vitrum/esp32-fs3000-project/docs/screenshort/IMG_1047.jpg

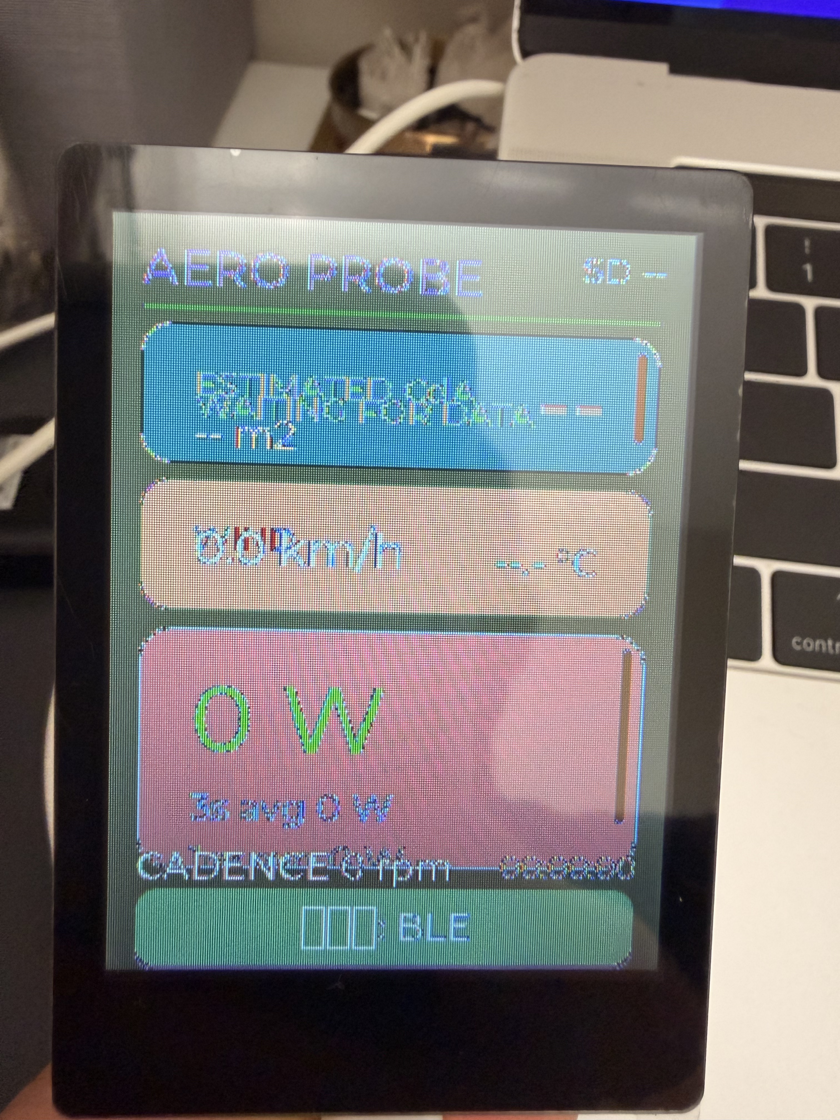
docs/screenshort/IMG_1047.jpg
