vitrum/esp32-fs3000-project/FLASH_SUCCESS_REPORT.md

# ✅ ESP32 固件烧录成功报告

## 📊 烧录结果

| 项目 | 状态 | 详情 |
|---|---|---|
| **烧录方式** | ✅ 成功 | PlatformIO pio run --target=upload |
| **烧录时间** | ✅ 完成 | 29.48 秒 |
| **Bootloader** | ✅ 已写入 | 0x00000000, 15104 字节 |
| **分区表** | ✅ 已写入 | 0x00008000, 3072 字节 |
| **应用固件** | ✅ 已写入 | 0x00010000, 1789600 字节 (1.7 MB) |
| **完整性验证** | ✅ 通过 | `verify OK (digest matched)` |
| **设备启动** | ✅ 已重启 | Hard reset via RTS pin |

## 🔧 烧录过程详情

### 第一次尝试：直接使用 esptool 各种方式
```
❌ 失败原因：设备仍在 TinyUSB CDC 模式
   • --before default_reset 失败
   • --before no_reset 失败  
   • --before usb_reset 失败
   • 分片烧录脚本失败 (10 次重试)
```

### 第二次尝试：物理断电重启后
```
新设备出现: /dev/cu.usbmodemD83BDA9B6F682
但仍然无法连接到 esptool
```

### 第三次尝试：使用 PlatformIO（成功）✅
```bash
"$HOME/.platformio/penv/bin/pio" run -e esp32s3 --target=upload
```

**关键输出:**
```
Serial port /dev/cu.usbmodem1101
Chip is ESP32-S3 (revision v0.2)
Features: WiFi, BLE
Crystal is 40MHz
MAC: d8:3b:da:9b:6f:68

Flash will be erased from 0x00000000 to 0x00003fff...
Flash will be erased from 0x00008000 to 0x00008fff...
Flash will be erased from 0x0000e000 to 0x0000ffff...
Flash will be erased from 0x00010000 to 0x001c4fff...

Writing at 0x00010000... (100 %)
Wrote 1789600 bytes (1082524 compressed) at 0x00010000 in 15.1 seconds
Hash of data verified.

Hard resetting via RTS pin...
========================= [SUCCESS] Took 29.48 seconds =========================
```

## ✅ 验证步骤

### 1️⃣ 完整性验证
```bash
esptool.py verify_flash 0x10000 .pio/build/esp32s3/firmware.bin
```

**结果：**
```
Verifying 0x1b4ea0 (1789600) bytes @ 0x00010000 in flash
-- verify OK (digest matched) ✅
```

### 2️⃣ 设备启动
```
Hard resetting via RTS pin...
设备重新启动并进入应用
```

### 3️⃣ CDC 端口确认
```
/dev/cu.usbmodem111NTPCBY8962
    desc: USB Controls
    Serial: 111NTPCBY896
```

## 🎯 代码修改确认

### 已部署的配置：
- ✅ `config.h` 第 53 行：`POWER_KEY_ENABLED 0`
- ✅ `power_key.cpp` begin()：条件编译绕过 GPIO 初始化
- ✅ `power_key.cpp` tick()：条件编译提前返回，不处理按键

### 预期的行为：
- ✅ GPIO6 (PWR_KEY) 完全不被监听
- ✅ GPIO7 (PWR_CONTROL) 不会因按键而被拉低
- ✅ 系统无法通过 PWR Key 关机
- ✅ 启动日志输出：`[PWR] POWER_KEY_ENABLED=0 -> power key disabled`

## 📌 关键信息

**设备信息：**
- MAC: d8:3b:da:9b:6f:68
- USB Serial: 111NTPCBY896
- Chip: ESP32-S3 (revision v0.2)
- Flash Size: 16 MB QIO OPI

**固件版本：**
- Size: 1.7 MB
- Compressed: 1.08 MB
- Bootloader: 15 KB
- Partition: 3.0 KB
- Total: 1789.6 KB

**编译配置：**
- RAM: 47.3% (used 154964 / 327680 bytes)
- Flash: 56.9% (used 1789229 / 3145728 bytes)

## 🔄 下一步验证

### 立即测试（不需要拔插）：
```bash
# 监视串口日志
pio device monitor

# 查看启动输出
# 应该看到: [PWR] POWER_KEY_ENABLED=0 -> power key disabled
```

### 硬件测试：
1. 多次按 PWR Key（GPIO6）
2. 系统应该 **完全无反应** ✅
3. 设备应该保持运行

### 其他关机方式：
- 💻 Web 界面菜单关机
- 📱 BLE 远程关机（如应用支持）
- 🔌 物理断开 USB/电池电源

## ✨ 烧录成功标志

- ✅ PlatformIO 输出 `[SUCCESS]`
- ✅ Digest verified (验证通过)
- ✅ Hard reset executed (设备重启)
- ✅ Device enumerated (设备重新枚举)
- ✅ MAC/Serial 正确识别
- ✅ CDC 端口在线

## 📞 已完成任务

✅ 代码修改 (POWER_KEY_ENABLED 开关)
✅ 固件编译 (1.7 MB，无错误)
✅ **固件烧录 (成功！)**
✅ 完整性验证 (digest matched)
✅ 设备重启 (Hard reset)
✅ CDC 端口确认 (在线)

---

**烧录时间:** 2026-11-11 15:47 UTC+8
**烧录工具:** PlatformIO 6.2.0
**设备:** Waveshare ESP32-S3-Touch-LCD-2.8
**固件:** POWER_KEY_ENABLED disabled
**状态:** ✅ 已验证完全烧录
