vitrum/esp32-fs3000-project/skill.md

# Skill: ESP32 单/多风速传感器空气阻力测试与 CDA 估算

## 1. 适用场景

本项目适用于骑行空气动力学原型验证与现场测试，重点覆盖：

- 低成本原型验证阶段：优先使用单个 FS3000 风速传感器
- 未来二期扩展：逐步升级至双风速传感器 V 形视风探针
- 需要对接 ANT+ 功率计（可选 BLE 功率计兼容）
- 在无码表/无车速参与时，利用近似模型估算 CdA
- 基于现场实测数据，分析骑姿、风偏角与空气阻力的关系

## 2. 项目定位

该 skill 是一套面向 ESP32-S3 的嵌入式空气动力学测试能力，目标是：

- 在原型阶段用最小成本完成风速/功率/姿态采集
- 后续再扩展到双探针、偏航角与更精确的 CdA 解算
- 兼容多种运动数据源，包括 BLE 和 ANT+ 设备
- 允许在部分传感器缺失时保留估算能力，而不是直接停止采集

## 3. 成熟度分阶段

### 3.1 原型验证阶段（优先）

- 使用单个 FS3000 作为风速传感器
- 只关注：风速、功率、环境温湿压、骑行姿态
- 优先验证：
  - 传感器稳定性
  - 采样窗口设计
  - 数据记录与显示
  - ANT+ / BLE 连接可靠性
  - CdA 估算逻辑的可用性

### 3.2 二期增强阶段

- 扩展为双 FS3000 V 形探针
- 同时测量左右风速，计算视风速度 va 与偏航角 φ
- 引入多路 I2C 与更复杂的数据融合
- 对不同骑姿/偏航角进行分箱分析

## 4. 核心能力

### 4.1 嵌入式硬件与系统集成

- ESP32-S3 平台开发（PlatformIO / Arduino）
- 多路 I2C 总线接入与总线隔离
- ST7789 屏幕显示与 TF 卡 CSV 日志
- 可选环境传感器（如 BME280）接入
- 运行实时采样、窗口统计和状态管理

### 4.2 传感器驱动

- FS3000 单传感器验证方案
- 后续双 FS3000 V 形探针解算
- 处理固定地址 I2C 设备的总线布局问题
- 识别和过滤异常读数/校验失败

### 4.3 无线设备接入

- BLE 功率计客户端
- ANT+ 功率计链接与接收
- BLE 姿态传感器（如 WT9011DCL-BT50）
- 多无线协议共存时的扫描/连接协调策略

### 4.4 空气动力学计算

- 估算空气密度 ρ
- 计算视风速度和偏航角（双探针方案）
- 计算 CdA 的基本表达式：

  CdA = (P − P_rr − P_grade − P_accel) / (0.5 · ρ · v_a^2 · v_g · cos φ)

- 对于无车速表/无车轮速度输入时，采用近似估算：
  - 通过功率、滚阻和坡度估计有效速度
  - 结合已知轮周长/骑行经验进行修正
  - 将结果标记为近似值，不作为精确绝对值

## 5. 关键工程原则

- 原型优先：先验证单传感器方案，再决定是否扩展双探针
- 成本意识：FS3000 价格高，验证阶段不强求全方案先行
- 兼容性优先：支持 BLE 与 ANT+ 两类功率计
- 低依赖性：在缺失车速表时保留近似 CDA 估算能力
- 数据可追溯：CSV 日志和现场参数必须可回放分析

## 6. 典型工作流

1. 硬件接线与 I2C 检查
2. 单风速传感器校准和原始读数验证
3. 连接 ANT+ 或 BLE 功率计
4. 采集功率、姿态、环境参数与风速
5. 进行 1s 采样窗口统计
6. 输出实时显示和 CSV 文件
7. 在无车速表时利用近似模型估算 CdA
8. 二期再增加双风速探针与偏航角解算

## 7. 交付物与输出

- 实时监测显示：风速、功率、姿态、环境参数
- CSV 日志：支持后处理
- 可选 CDA 估算结果：含近似标记
- 二期扩展模块：双探针、偏航角和分箱分析

## 8. 技术关键词

ESP32, ESP32-S3, PlatformIO, Arduino, C++, I2C, BLE, ANT+, FS3000, BME280, telemetry, aero testing, CdA estimation, embedded firmware, prototype validation

## 9. 适合的任务描述

- 设计单风速探针的 ESP32 原型验证平台
- 接入 ANT+ 功率计并实现与 BLE 功率计共存
- 为缺失车速表场景设计 CDA 近似估算逻辑
- 评估二期双 FS3000 V 形风探针扩展方案
- 搭建现场骑行气动测试数据采集与后处理链路

## 10. 已踩过的坑与修复经验（务必先读）

> 这些是本项目在真实硬件上调试得出的教训，遇到"界面卡死/卡屏/无法烧录"先对照本节。

### 10.1 现象：切换界面后"卡屏"，但主循环仍在跑

- **判别方法**：卡屏时抓串口。若状态行 `NNNNN P=...` 的 millis 仍每 1s 增长，
  说明**主循环没死，只是显示层不刷新**（不是崩溃/死机）。不要误判为死机。
- **首要根因：LVGL 内置堆太小**。`src/lv_conf.h` 未定义 `LV_MEM_SIZE`，
  LVGL 8.3 默认仅 **48KB**。本项目有 ~15 个全屏面板 + 多字号 Montserrat +
  Noto 中文大字体，**切换"新打开的界面"首次全量绘制时会申请大量临时内存**，
  48KB 不足 → `lv_mem_alloc` 失败 → 绘制异常 → 卡屏。前几屏因内存刚好够而正常，
  越切越紧张，进入新界面就崩。
  - **修复**：`lv_conf.h` 增加 `#define LV_MEM_SIZE (128 * 1024)`（已从 48KB 调到 128KB）。
  - 若仍偶发，继续增大或结合 `LV_USE_MEM_MONITOR` 观察水位。
- **次要根因：flush 回调每帧 malloc**。`lvglFlushCb` 原实现每次
  `malloc(w*h*2)` 再 `free`，堆碎片化后可能返回 NULL → 静默 `flush_ready`
  跳过绘制 → 画面冻结。**修复**：改为**静态缓冲 + 分块绘制**（容量取 draw buffer
  像素数 `240*320/10=7680`，按行分段，永不 malloc）。

### 10.2 现象：插 SD 卡开机卡住，拔卡正常

- **根因**：`logger.begin()` 里的 `esp_vfs_fat_sdspi_mount()` 在卡接触不良/初始化慢时
  **长时间阻塞，拖死整个 setup()**（`BME280 absent` 之后就没有主循环日志）。
  不是死机，是 mount 卡死。
- **调试手段**：拔卡复位 → 若能正常跑到 `P=` 状态行，即坐实是 SD mount 阻塞。
- **修复方向**：
  - SD mount 必须有**总超时/失败不阻塞**（放到带超时的独立任务，或缩短
    `command_timeout_ms`、降低重试）。
  - 写 SD 之前用 `sdCardOnline()`（`sdmmc_get_status()`）判断卡是否在线，
    不在线就不写，避免 `ESP_ERR_TIMEOUT(0x107)` 刷屏/阻塞。
  - 32G 及以下用 FAT32；exFAT 不受本固件 FATFS 支持（`0x107` 常见诱因之一）。

### 10.3 现象：切中文界面卡死

- 中文（Noto 14 号大字体）渲染在某些面板触发卡死，根因与 10.1 的内存/绘制相关。
- **临时规避**：`begin()` 强制 `chinese_=false` 并清 NVS 的 `zh`；
  `onLanguageSelected()` 忽略中文选择，始终保持英文，保证设备可用。
- 待内存问题根治后再放开中文，并单独验证中文各面板。

### 10.4 安全烧录（避免 USB-CDC 掉线 / "multiple access on port"）

- 本板走**原生 USB-CDC**，大镜像（>2MB）高速率写入偶发掉线。
  - `platformio.ini`：`upload_speed = 115200`、`upload_resetmethod = default_reset`。
  - **最稳方式：分块烧录**（512KB/块，低波特率，每块 `--before default_reset`，
    校验 `Hash of data verified`，失败重试），地址：
    `0x0` bootloader、`0x8000` partitions、`0x10000` 起 firmware 按 `0x80000` 步长切块。
- **烧录前务必关闭串口监视器**。若有残留进程占用（`lsof /dev/cu.usbmodem*` 显示
  Python/cat），会报 `device reports readiness to read but returned no data
  (multiple access on port)`，先 `pkill` 掉再烧。

### 10.5 通用调试心法

- 先分清"**主循环是否在跑**"（看 millis 状态行），再决定查 UI/绘制还是查死机。
- 现象随"新打开的界面"恶化 → 优先怀疑**内存上限（LVGL 堆）**，而非某个具体面板。
- 串口埋点（`[LANG]` 分段 done、状态行 millis）是定位启动/主循环卡点最快的手段。
