vitrum/esp32-fs3000-project/code/docs/数据传输技术方案分析.md

# ESP32-S3 移动传感器数据传输技术方案分析报告（更新版）

> 版本：v2.0　|　适用平台：Waveshare ESP32-S3-Touch-LCD-2.8
> 本文所有关键技术参数均来自 Espressif 官方文档（ESP-IDF Programming Guide）与产品规格，文末附来源。
> 标注「实测参考」的数据为社区普遍反馈的经验值，标注「官方」的为核心技术约束，请区别对待。

---

## 一、核心需求场景

| 项 | 描述 |
|---|---|
| 移动端 | 微雪 ESP32-S3-Touch-LCD-2.8（2.8 寸 240×320 电容触摸屏），持续移动中采集传感器数据 |
| 接收端 | 电脑或手机，位于 **100 米视线距离**（空旷无障碍）的固定位置 |
| 数据特征 | 小型、高频、实时的传感器数据流（本项目为功率/踏频/风速/姿态等遥测帧） |
| 核心目标 | 解决移动状态下 100 米远距离传输的信号衰减问题，实现高可靠、低延迟的数据交互 |

**本项目的实际数据流参考**（来自现有实现 `wifi_web.h`）：
传感器以 8Hz 采样，聚合成 1Hz 遥测帧，经 WebSocket 推送，单帧约 200~400 字节。
即**有效带宽需求 < 1 kbps**，这对任何无线方案都是极低的负载——因此本场景的真正瓶颈
**不是带宽，而是链路可靠性、覆盖距离与部署复杂度**。这一判断贯穿全文。

---

## 二、交互分析与技术瓶颈演进

### 2.1 随身 WiFi 的局域网组网可行性

**结论：理论可行，但有严重的前置条件限制。**

**瓶颈原因：**

1. **AP 隔离（AP Isolation / Client Isolation）**
   多数随身 WiFi / 手机热点的默认策略是隔离同一 AP 下的客户端互访，
   这是运营商的**安全默认值**，会直接拦截「ESP32 → 电脑」的局域网直连。

2. **系统防火墙**
   即使关闭 AP 隔离，Windows 首次遇到未知入站连接会默认拦截，
   macOS 也会弹出「是否允许接受传入连接」。用户侧极易配置失败。

3. **DHCP 地址漂移**
   热点重启后接收端 IP 常变化（如 `192.168.43.100` → `192.168.43.101`），
   硬编码目标 IP 的推送代码会直接失效，需要额外的设备发现机制（mDNS / UDP 广播）。

4. **⚠️ 与项目现有架构的冲突（重要）**
   本项目 `WifiWeb` 的定位是 **STA 客户端 + WebSocket 服务端**，
   数据由**浏览器/客户端主动订阅**。而方案二要求 ESP32 作为**主动推送方**（UDP/TCP Client）。
   这一改动不是「加几行代码」，而是需要新增独立的发送通道，
   并处理与 LVGL 主循环的线程安全（WebSocket 回调运行在 AsyncTCP 任务中，
   直接操作 LVGL 会崩溃——本项目已有 `ui_navigation_guard.h` 专门处理此类问题）。

**评价**：可行但脆弱，属于「能跑通，但现场部署成功率低」的方案。

---

### 2.2 100 米无线视线传输瓶颈

**结论：普通便携随身 WiFi 或 ESP32 板载天线的默认 802.11b/g/n 模式，确实无法稳定支撑 100 米移动传输。**

**瓶颈原因（含官方数据）：**

1. **板载天线的物理限制**
   便携随身 WiFi 与微雪开发板均为板载 PCB 天线，增益通常仅 2~3 dBi，
   且辐射方向图在设备旋转时存在明显零点（null）。
   > 实测参考：开阔环境下稳定距离通常 30~50 米，与文档原始结论一致。

2. **自由空间路径损耗（FSPL）**
   2.4 GHz 下，距离每翻倍损耗增加约 6 dB：

   ```
   FSPL(dB) = 20·log10(d) + 20·log10(f) − 147.55     (d 单位 m, f 单位 Hz)
   ```

   2.4 GHz 在 1 m 处约 40.0 dB，100 m 处约 **80.0 dB**。
   若发射功率 20 dBm、接收灵敏度 −90 dBm，链路预算约 110 dB，
   扣除 80 dB 路径损耗后仅剩 **30 dB 余量**——听起来够用，
   但人体遮挡可再衰减 **10~20 dB**，设备旋转再损失 5~10 dB，
   余量迅速归零。这正是「静止能通、一动就断」的物理原因。

3. **多径效应与阴影效应**
   持续移动中，人体遮挡、设备角度旋转导致 2.4 GHz 信号快速衰落；
   OFDM 在低 SNR 下会主动降速率，重传率飙升，表现为「延迟抖动极大」。

4. **漫游/重连开销**
   STA 模式一旦断开，重连需重新扫描 + 认证 + DHCP，
   典型耗时 **1~5 秒**，期间数据完全丢失。移动场景下这会发生得非常频繁。

**✅ 关键补充：ESP32 原生支持 Long Range 模式**

这是原始文档遗漏的重要能力。ESP-IDF 官方文档明确说明：

> 「The Espressif-specific ESP-NOW protocol and **Long Range mode, which supports up to 1 km of data traffic**」
> —— ESP32 Wi-Fi Feature List（ESP-IDF v6.1）

Long Range 模式即 **802.11 LR**（Espressif 私有扩展，基于 802.11b 的 DSSS 扩频调制），
官方定义的速率档位只有两档：

```c
WIFI_PHY_RATE_LORA_250K = 0x29,  /**< Espressif-specific Long Range mode rate, 250 Kbps */
WIFI_PHY_RATE_LORA_500K = 0x2A,  /**< Espressif-specific Long Range mode rate, 500 Kbps */
```

速率降低换来的正是**接收灵敏度提升**，链路预算显著优于标准 11b/g/n。
对本项目而言，1Hz × 300 字节 ≈ **2.4 kbps** 的需求，
**250 kbps 的 LR 速率仍有 100 倍余量**，完全不必担心降速影响。

启用方式（`esp_wifi_set_protocol`，官方 API）：

```c
// 官方文档：When WiFi band mode is 2.4G only, support 802.11b or 802.11bg
// or 802.11bgn or 802.11bgnax or LR mode
esp_wifi_set_protocol(WIFI_IF_STA, WIFI_PROTOCOL_LR);
```

> ⚠️ **重要约束**：LR 模式**必须双方都支持**。
> 普通路由器、手机热点**不支持** LR，因此 LR 只能用于 **ESP ↔ ESP** 的点对点场景。
> 这直接决定了：**LR 是方案三（ESP-NOW）的专属优势，无法用于方案一/二的 WiFi 组网。**

---

### 2.3 外接 5G 模块改造的可行性

**结论：理论可行，但属于高难度、高风险的非最优解。**

**瓶颈原因：**

1. **引脚冲突（本项目实测确认）**
   微雪该板高度集成屏幕（SPI）、触摸（I2C）、SD 卡（SPI）、音频（I2S）、GPS（UART）。
   查看本项目 `config.h` 可知已占用引脚：

   | 功能 | 引脚 |
   |---|---|
   | LCD SPI | 45/40/42/41/39/5 |
   | 触摸 I2C | 1/3/4/2 |
   | I2C1（传感器） | 11/10 |
   | I2C2 | 15/18（15 与 GPS_PPS 复用） |
   | SD 卡 SPI | 14/16/17/21 |
   | 电源按键 | 6/7 |
   | I2S 音频 | 48/38/47 |
   | GPS UART | 43/44 |
   | BOOT | 0 |

   实测汇总（`grep PIN_ src/config.h`）后，
   **真正空闲可用的仅 GPIO 8/9/12/13/19/20/46**（22~25 不存在，26~37 被 Flash/PSRAM 占用）。
   5G 模组需要 USB 2.0 高速接口（或至少多路 UART + 电源控制），
   **被迫只能走单路 UART AT 指令**，带宽受限、扩展性被破坏。

2. **供电灾难（物理硬约束）**
   5G 模组搜网/发射瞬间电流峰值达 **2~3 A**，
   而微雪板载 LDO（ME6217C33M5G，800 mA 输出）**远不足以支撑**，
   会导致电压跌落 → ESP32 欠压复位 → 反复重启，甚至损坏 LDO。
   若一定要做，必须**独立供电 + 大电容缓冲**，已超出「开发板改造」的范畴。

3. **成本与体积**
   5G 模组 + SIM + 独立电源管理，成本可能超过开发板本身，且体积臃肿。

**评价**：不推荐。若确实需要广域联网，**方案一（口袋 WiFi）** 是同等效果、零风险的替代。

---

## 三、最终优选解决方案评级

### 🥇 方案一：口袋 WiFi + 云端物联网平台（MQTT）中转

**架构设计：**

```
[ESP32-S3] ──WiFi(厘米级)── [口袋 WiFi/4G 路由器] ──运营商基站── [互联网]
                                                                    │
                                                          [MQTT Broker]
                                                                    │
[固定端 电脑/手机] ──────────── 任意网络（WiFi/4G/有线）────────────┘
```

将微雪板与口袋 WiFi **捆绑在一起移动**，两者距离仅厘米级，
WiFi 信号处于绝对完美的顶格状态（RSSI 通常 −30 ~ −40 dBm）。

**通信机制：**

- 口袋 WiFi 连接运营商基站接入互联网。
- ESP32-S3 作为 **MQTT Client**，将传感器数据 **Publish** 到云端 Broker。
- 固定端连接任意网络，**Subscribe** 相同 Topic 实时接收。

**为什么这是最优解：**

| 优势 | 说明 |
|---|---|
| **彻底消灭距离限制** | 传输距离从「100 米」变成「全球可达」 |
| **完美绕过 AP 隔离/防火墙** | 通信由 ESP32 主动发起走向公网，不涉及局域网互访 |
| **工业级标准** | MQTT 轻量、发布/订阅、支持 QoS 1/2 保证送达 |

**✅ 技术可行性（本项目实测依据）：**
本项目已基于 ESP-IDF 实现完整的 `WifiWeb` 模块（`src/wifi_web.h`），
包含 SmartConfig 配网、STA 连接、断线重连、WebSocket 推送，
**证明该平台跑通「WiFi + 长连接 + 实时推送」链路完全可行**。
迁移到 MQTT 只需替换传输层：
- ESP-IDF 官方组件：`espressif/mqtt`（ESP-MQTT，支持 MQTT v5.0）
- 示例：`protocols/mqtt`（TLS + 证书验证）

> ⚠️ **必须正视的代价（原始文档未提及）：**
>
> 1. **延迟增加**：数据需经「ESP32 → 口袋 WiFi → 基站 → 公网 → Broker → 固定端」，
>    典型端到端延迟 **100~500 ms**（公网 + 运营商 NAT）。
>    对「1Hz 遥测」完全可接受，但**不适用于需要 <10ms 的实时控制**。
> 2. **依赖移动网络覆盖**：山区、地下室、隧道内会失联。
>    **建议保留 SD 卡本地记录作为兜底**——本项目已实现完整 FIT/CSV 记录，正好互补。
> 3. **流量成本**：1Hz × 300 字节 ≈ **2.6 MB/小时**，按 4G 资费需评估。
>    可通过降低频率或改用二进制载荷（如 CBOR）压缩 60%+。
> 4. **TLS 内存开销**：MQTT over TLS 握手需约 **40~50 KB** 堆内存。
>    本项目当前 RAM 已用 45.4%（约 148 KB / 320 KB），
>    **开启 TLS 前需评估剩余堆空间**，必要时改用非加密端口或 PSK。

**公共测试 Broker（免注册，快速验证）：**
`broker.emqx.io:1883`（TCP）/ `:8883`（TLS）——适合原型验证，**生产环境禁止使用**。

---

### 🥈 方案二：口袋 WiFi + 本地局域网主动推送

**架构设计：**
同样将板子与口袋 WiFi 捆绑，但**必须关闭 AP 隔离**。
ESP32 作为 Client，用 UDP 或 TCP Socket **主动推送到固定端 IP:Port**。

**优缺点：**

| 优点 | 缺点 |
|---|---|
| 延迟极低（同局域网通常 <5 ms） | AP 隔离需手动关闭，现场易失败 |
| 不经云端，无需公网/流量费 | 目标 IP 常变（DHCP），需设备发现机制 |
| 单片机开销小 | 无 QoS 保证，UDP 丢包无感知 |
| 数据不出内网（隐私性好） | **禁止 ESP32 做 HTTP 服务端**（见下） |

> **⚠️ 关于「禁止 ESP32 充当 HTTP 服务器」的澄清：**
> 原始结论方向正确，但表述需要修正。
> 本项目**已经**在 ESP32 上运行 `AsyncWebServer`（异步非阻塞），
> 并未导致 LVGL 卡顿——关键在于 **异步架构** 与 **回调中不触碰 LVGL**。
> 真正会导致卡死的是：
> ① 在 HTTP 回调中直接操作 LVGL 对象；② 在主循环中同步阻塞等待网络。
> 本项目通过 `ui_navigation_guard.h` 与「只置标志位、主循环消费」的模式规避了此问题。
> **因此：「ESP32 可以安全地做 HTTP 服务端，前提是严格异步 + 线程安全」。**

**技术方案对比（UDP vs TCP）：**

| 维度 | UDP 单播 | TCP Socket | ESP-NOW（见方案三） |
|---|---|---|---|
| 延迟 | 最低 | 低 | 最低（免握手） |
| 丢包处理 | 需应用层序号 | 自动重传 | 需应用层序号 |
| 连接开销 | 无 | 三次握手 | 无连接 |
| 适用 | 高频遥测（丢帧可容忍） | 需可靠传输 | 中短距点对点 |

**评价**：适合**纯内网、可控环境**（如实验室、固定场地测试）。
现场部署可靠性低于方案一。

---

### 🥉 方案三：纯硬件不对称升级（ESP-NOW 专网 + 高增益基站）

**架构设计：**

```
[微雪板 + 板载天线]  ──ESP-NOW / 802.11 LR──  [ESP32 基站 + IPEX 高增益天线]
     (移动端)                                           │ USB 串口
                                                  [电脑 上位机]
```

抛弃随身 WiFi，利用 Espressif 私有协议 ESP-NOW（**无连接、2.4 GHz**）。

**ESP-NOW 官方技术规格（ESP-IDF v6.1 文档）：**

| 项目 | 参数 |
|---|---|
| 默认速率 | **1 Mbps**（可通过 `esp_now_set_peer_rate_config` 调整） |
| 最大载荷 | v1.0 **250 字节** / v2.0 **1470 字节** |
| 加密 | CCMP（AES-128），PMK + 每设备 LMK |
| 配对设备数 | 总数最多 **20**（`ESP_NOW_MAX_TOTAL_PEER_NUM`），加密最多 **6**（`ESP_NOW_MAX_ENCRYPT_PEER_NUM`，可 Kconfig 调整） |
| 信道 | 0~14（双方必须**同信道**） |
| 连接 | **无连接**，收到即回调 |

**✅ 与 Long Range 模式叠加（关键增益）：**
ESP-NOW 可配合 `WIFI_PROTOCOL_LR` 使用，
官方标称 LR 模式可支撑 **1 km** 链路——**远超 100 米需求，余量充足**。

```c
// 发送端与接收端都必须设置（注意：ESP-NOW 默认 1 Mbps，LR 才会降低速率提升灵敏度）
esp_wifi_set_protocol(WIFI_IF_STA, WIFI_PROTOCOL_LR);

// esp_now_rate_config_t 是 wifi_tx_rate_config_t 的 typedef，字段以 esp_wifi_types.h 为准。
// 必须先在 esp_wifi_start() + esp_now_add_peer() 之后调用。
// ⚠️ LR 模式下 rate 应使用 WIFI_PHY_RATE_LORA_250K（本项目使用的 ESP32-S3 特有速率），
//    具体枚举名随 IDF 版本不同，请以所用版本的 esp_wifi_types_generic.h 为准。
esp_now_rate_config_t cfg = {};
cfg.phymode = WIFI_PHY_MODE_LR;   // 关键：LR PHY（扩频，灵敏度提升）
cfg.rate    = WIFI_PHY_RATE_LORA_250K;
cfg.ersu    = false;
cfg.dcm     = false;
esp_now_set_peer_rate_config(peer_mac, &cfg);
```

**优缺点：**

| 优点 | 缺点 |
|---|---|
| **无需网络/流量/云端，零月费** | **需要写两端代码**（发送端 + 接收端） |
| **延迟极低**（官方：无连接，收即回调） | 基站需额外一块 ESP32 硬件 |
| LR 模式理论覆盖 1 km | **双方必须同信道**，信道受干扰时需手动切换 |
| 800 米内大概率稳定 | 无内置重传，**需应用层加序号 + ACK** |
| 完全离线，隐私性最佳 | 电脑侧需串口/驱动，体验不如网页 |

> ⚠️ **ESP-NOW 可靠性设计要点（必须自行实现）：**
> 官方文档明确指出：
> 「It is **not guaranteed** that application layer can receive the data.
> If necessary, send back ack data when receiving ESP-NOW data.
> If receiving ack data timeouts, **retransmit** the ESP-NOW data.
> A sequence number can also be assigned to ESP-NOW data to **drop the duplicate data**.」
>
> 即：ESP-NOW 的 `SEND_SUCCESS` **仅代表 MAC 层发出**，
> **不代表应用层收到**。生产环境必须实现：① 应用层 ACK；② 超时重传；③ 序列号去重。

**评价**：技术上最优（延迟最低、无月费、覆盖充足），
但**开发工作量最大**（两端固件 + 上位机），适合长期固定部署。

---

## 四、三方案横向对比与选型建议

| 维度 | 🥇 MQTT 云端 | 🥈 局域网推送 | 🥉 ESP-NOW + LR |
|---|---|---|---|
| **有效距离** | 全球（依赖 4G 覆盖） | ~30~50 m（WiFi 极限） | **100 m 轻松，理论 1 km** |
| **端到端延迟** | 100~500 ms | < 5 ms | **< 5 ms** |
| **可靠性** | 高（QoS 1/2 + 重连） | 中（UDP 丢包） | 中（需自建 ACK/重传） |
| **部署难度** | 低（需配网 + Broker） | 高（关隔离 + 防火墙 + IP） | 中（需第二块板） |
| **持续成本** | 流量费 + Broker 费 | 无 | **无** |
| **离线可用** | ❌ 依赖公网 | ⚠️ 依赖局域网 | ✅ **完全离线** |
| **隐私性** | 数据经公网 | 内网 | **最佳** |
| **开发工作量** | 中 | 中 | **高（两端 + 上位机）** |
| **与现有代码契合** | **高**（已有 WiFi/WebSocket 栈） | 中 | 低（需全新实现） |

### 选型决策树

```
是否需要「任意地点、任意距离」接收？
├─ 是 ──→ 🥇 MQTT 云端（配合 SD 卡兜底）
└─ 否（固定场地，如实验室/赛场）
    ├─ 能否接受额外一块 ESP32 + 写两端代码？
    │   ├─ 能 ──→ 🥉 ESP-NOW + LR（最优延迟、零月费、室内 100m 富余）
    │   └─ 不能 ──→ 🥈 局域网推送（需可控网络环境）
```

### 推荐组合（工程实践）

> **🥇 MQTT 云端 + SD 卡本地记录（双通道）**
>
> 这是最稳妥的工业级组合，理由：
> 1. 实时性：MQTT 满足 1Hz 遥测；
> 2. 完整性：网络中断时 SD 卡完整记录，事后补传；
> 3. 本项目**两者均已具备**（`wifi_web` + `csv_logger`/`fit_export`），
>    只需增加 MQTT 发布层，**改动最小、风险最低**。

---

## 五、针对本项目的落地建议

### 5.1 若采用方案一（推荐）

1. **保留 SD 卡记录**作为离线兜底，不做「只传不存」的设计。
2. **MQTT 载荷用二进制**（struct 直发），而非 JSON 字符串，
   可将 300 字节压到 ~80 字节，流量降 70%。
3. **QoS 选择**：遥测用 **QoS 0**（最省流量，丢帧可容忍）；
   关键事件（开始/停止记录）用 **QoS 1**。
4. **TLS 内存评估**：当前 RAM 45.4%，TLS 需 +40~50 KB，
   **建议先做非加密原型验证，再评估是否启用 TLS**。
5. **保留现有 WebSocket** 作为「同一 WiFi 下的低延迟调试通道」。

### 5.2 若采用方案三（离线优先）

1. **基站端**建议用 ESP32-S3 + IPEX 外置天线，
   **务必两端都设 `WIFI_PROTOCOL_LR`**，否则 LR 优势失效。
2. **信道固定**（如 Channel 1），避免自动信道导致失联。
3. 必须实现 **ACK + 重传 + 序列号去重**（官方明确不保证送达）。
4. 上位机可用 **pyserial + 简单二进制协议**，无需额外驱动。

### 5.3 关键风险提示（本项目特有）

| 风险 | 说明 | 缓解 |
|---|---|---|
| **RAM 吃紧** | 45.4% 已用，TLS/MQTT 会再增 | 先测堆余量，必要时降 TLS |
| **LVGL 线程安全** | 网络回调中碰 LVGL 必崩 | 沿用 `ui_navigation_guard.h` 模式 |
| **供电峰值** | 5G/WiFi 发射瞬间电流大 | 板载 LDO 仅 800 mA，**禁止外接 5G** |
| **GPS 与 WiFi 共存** | 两者任务抢占 CPU | 本项目已有 `system_coexistence` 测试覆盖 |

---

## 六、结论

1. **原始文档的两个核心判断正确**：
   ① 板载天线的默认 WiFi 无法稳定支撑 100 米移动传输；
   ② 外接 5G 模组在供电和引脚上均不可行。

2. **需要补充的重要结论**：
   - ESP32 的 **Long Range 模式官方标称 1 km**，这是方案三的核心技术支撑，
     也是「100 米」需求最经济的解法（**无需任何云端/流量**）。
   - 方案一的真实代价是 **100~500ms 延迟 + 依赖公网 + 流量费**，
     应配合 SD 卡兜底，而非替代本地记录。

3. **最终推荐**：
   - **需要远程/任意地点接收** → 🥇 **MQTT 云端 + SD 卡双通道**（本项目改动最小）。
   - **固定场地、追求低延迟零月费** → 🥉 **ESP-NOW + Long Range**（100 米余量充足）。

---

## 附录 A：关键公式与参数速查

**自由空间路径损耗**
```
FSPL(dB) = 32.44 + 20·log10(d_km) + 20·log10(f_MHz)
2.4 GHz @ 100 m  ≈ 80.0 dB
2.4 GHz @ 1 km   ≈ 100.0 dB
```

**链路预算（接收端功率）**
```
P_rx = P_tx + G_tx + G_rx − FSPL − L_margin
典型：20 dBm + 2 dBi + 2 dBi − 80 dB = −56 dBm   （100 m，完全无遮挡）
人体遮挡 −15 dB                      → −71 dBm  （仍可通，11b 灵敏度约 −90 dBm）
强遮挡 + 设备旋转 −30 dB             → −86 dBm  （临界，需 LR / 高增益天线）
```
> 11b 灵敏度约 −90 dBm，11n 约 −70 dBm。这也是**移动场景脆弱的根因**：
> 一旦降到 11n 速率档，−71 dBm 已接近极限；而 LR 模式灵敏度更低，余量充足。

**Long Range（LR）速查（官方枚举值）**
```
WIFI_PHY_MODE_LR           = 低速率 PHY 模式
WIFI_PHY_RATE_LORA_250K    = 0x29, 250 Kbps
WIFI_PHY_RATE_LORA_500K    = 0x2A, 500 Kbps
```

**本项目带宽估算**
```
1 Hz × 300 字节 = 300 B/s ≈ 2.4 kbps ≈ 1.05 MB/小时
二进制压缩后 ≈ 80 字节/帧 ≈ 0.64 kbps ≈ 0.28 MB/小时
```

## 附录 B：参考资料（Espressif 官方）

| 内容 | 来源 |
|---|---|
| Long Range 支持 1 km | ESP-IDF Wi-Fi Feature List，`api-guides/wifi-driver/overview.html` |
| `WIFI_PROTOCOL_LR` 属 2.4G 可选协议 | ESP-IDF `api-reference/network/esp_wifi.html` |
| ESP-NOW 帧格式/速率/载荷/ACK 语义 | ESP-IDF `api-reference/network/esp_now.html` |
| ESP-NOW Rate Config / LR PHY | `esp_now_set_peer_rate_config` API |
| Wi-Fi 吞吐 / 省电 / 缓冲区 | `api-guides/wifi-driver/wifi-performance-and-power-save.html` |
| ESP-MQTT（v5.0，TLS 示例） | ESP-IDF `api-reference/protocols/mqtt.html` |
| 板载资源与引脚 | Waveshare ESP32-S3-Touch-LCD-2.8 官方 Wiki |
| 本项目引脚占用 | `code/src/config.h` |
| 本项目 WiFi 架构 | `code/src/wifi_web.h` |
