vitrum/esp32-fs3000-project/code/output/imu_position_visualization.png

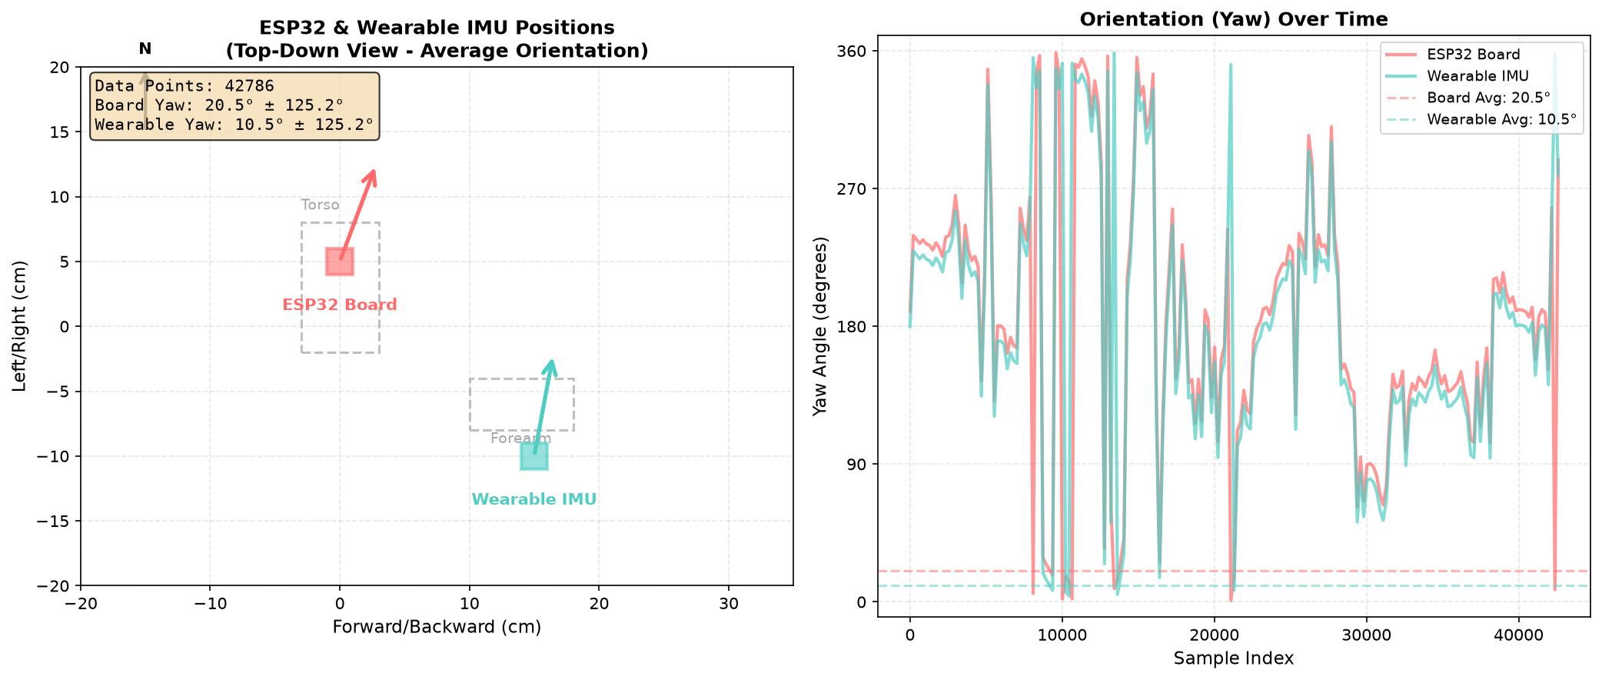
code/output/imu_position_visualization.png
