vitrum/esp32-fs3000-project/docs/ESP32-S3-Touch-LCD-2.8-introduction-03-d0ba2f9f1b4e9e7c740633f970b7858b.webp

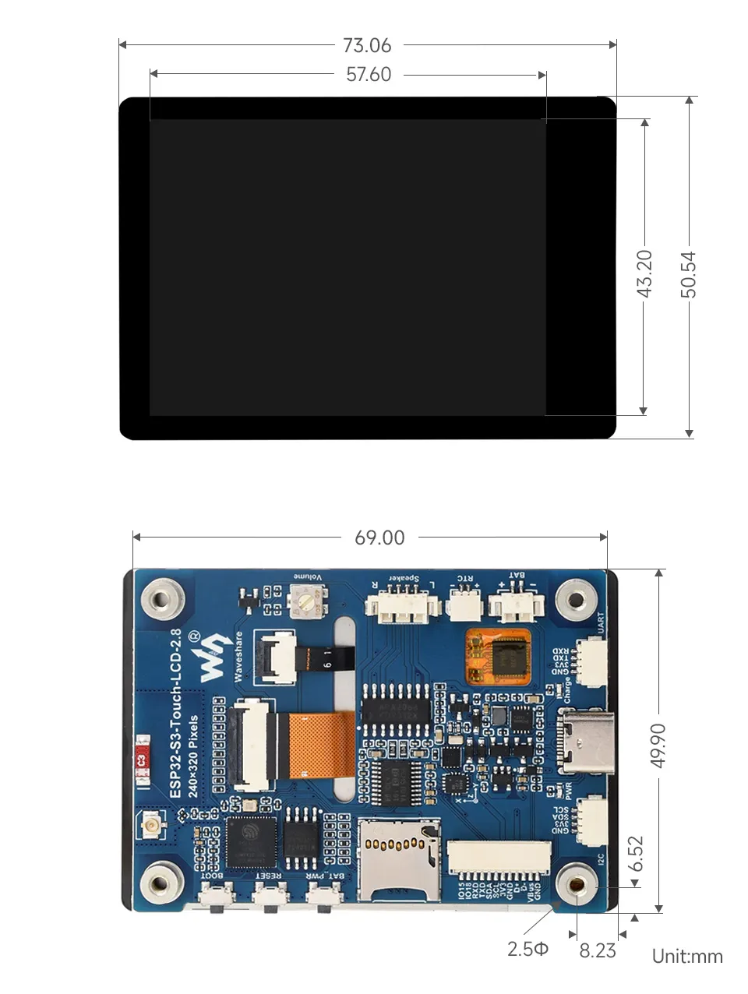
docs/ESP32-S3-Touch-LCD-2.8-introduction-03-d0ba2f9f1b4e9e7c740633f970b7858b.webp
