vitrum/esp32-fs3000-project/cad/aerodynamic_V15.stl

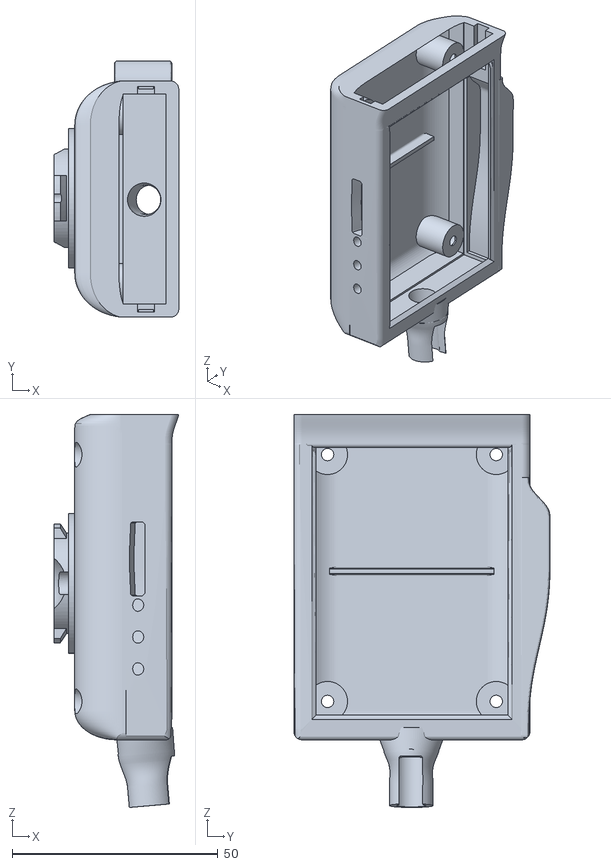
[picture p5: CAD file, 2026-11-05]
cad/aerodynamic_V15.stl
30.3 x 62.3 x 95.5
