vitrum/esp32-fs3000-project/cad/esp32-s3-touch-lcd-2_8_revised_stls/obj_5_esp32-s3-touch-lcd-2_8_5.stl

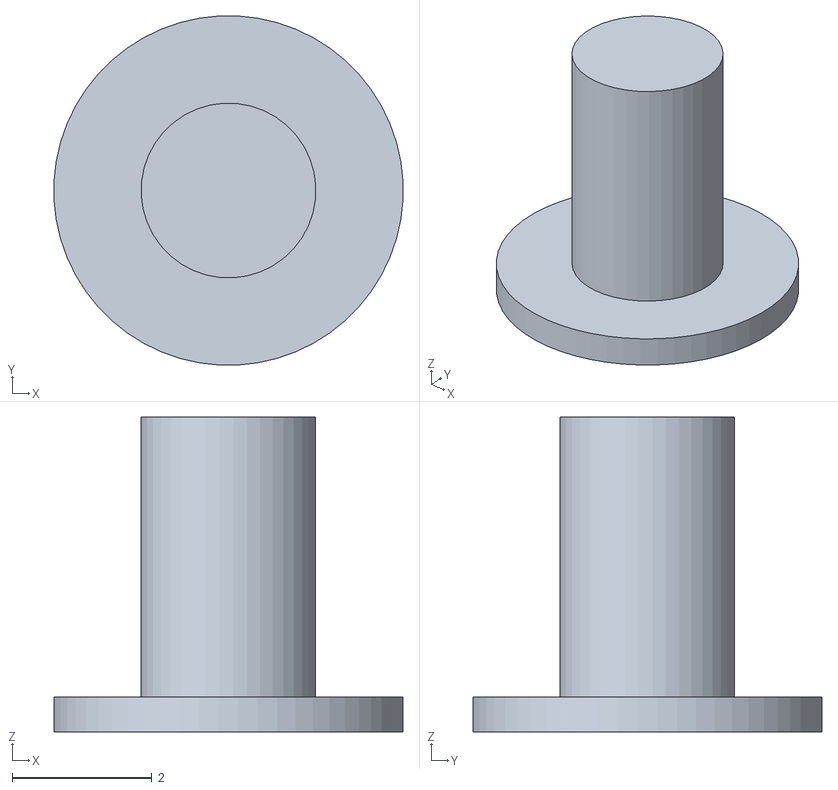
[picture p6: CAD file, 2026-10-12]
cad/esp32-s3-touch-lcd-2_8_revised_stls/obj_5_esp32-s3-touch-lcd-2_8_5.stl
4.99 x 4.99 x 4.50
