vitrum/esp32-fs3000-project/cad/aerodynamic_cycling_computer_V5_rounded_edges_f6.stl

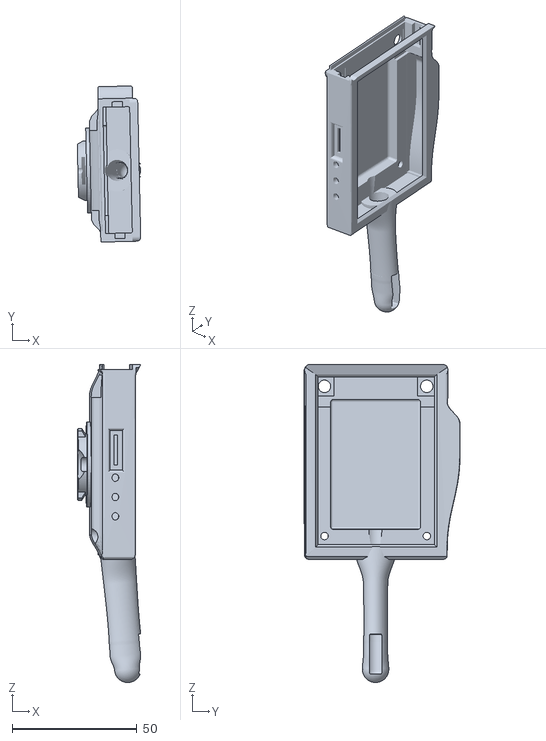
[picture p7: CAD file, 2026-10-16]
cad/aerodynamic_cycling_computer_V5_rounded_edges_f6.stl
25.4 x 62.5 x 127.4
