vitrum/esp32-fs3000-project/cad/esp32-s3-touch-lcd-2_8_revised_stls/obj_2_esp32-s3-touch-lcd-2_8_4.stl

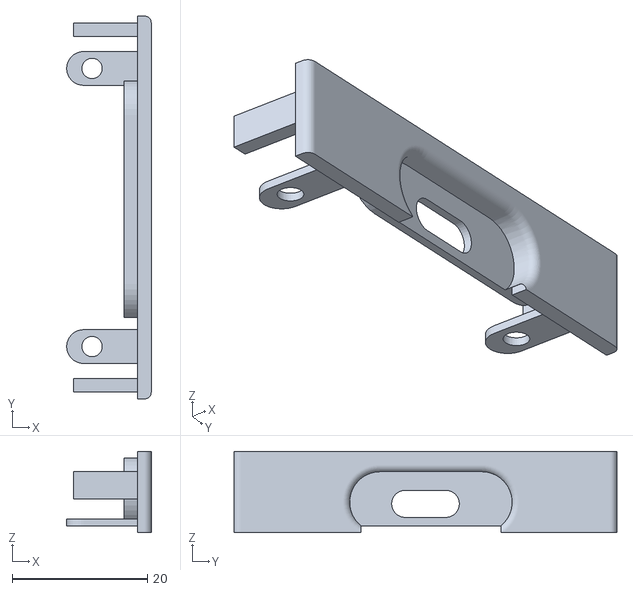
[picture p8: CAD file, 2026-10-12]
cad/esp32-s3-touch-lcd-2_8_revised_stls/obj_2_esp32-s3-touch-lcd-2_8_4.stl
12.5 x 56.6 x 12.0
