vitrum/esp32-fs3000-project/cad/aerodynamic_cycling_computer_V3_spherical_probe.stl

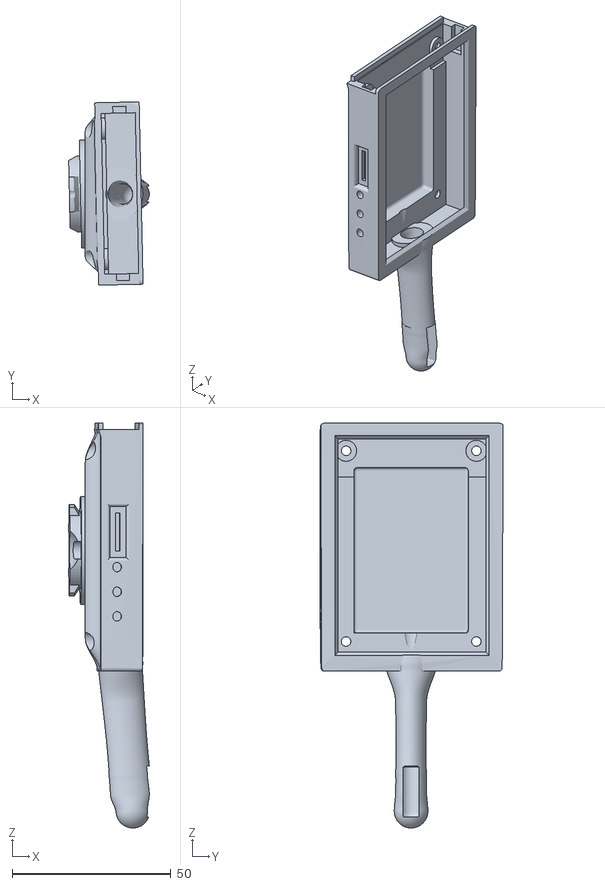
[picture p9: CAD file, 2026-10-15]
cad/aerodynamic_cycling_computer_V3_spherical_probe.stl
25.4 x 57.7 x 127.4
