vitrum/esp32-fs3000-project/cad/esp32-s3-touch-lcd-2_8_revised_stls/obj_1_esp32-s3-touch-lcd-2_8_3.stl

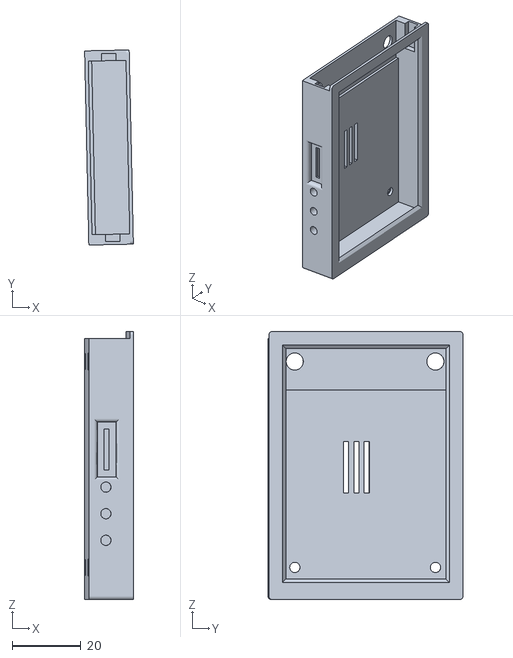
[picture p10: CAD file, 2026-10-12]
cad/esp32-s3-touch-lcd-2_8_revised_stls/obj_1_esp32-s3-touch-lcd-2_8_3.stl
14.2 x 56.9 x 78.1
