vitrum/esp32-fs3000-project/cad/aerodynamic_cycling_computer_print_reinforced.stl

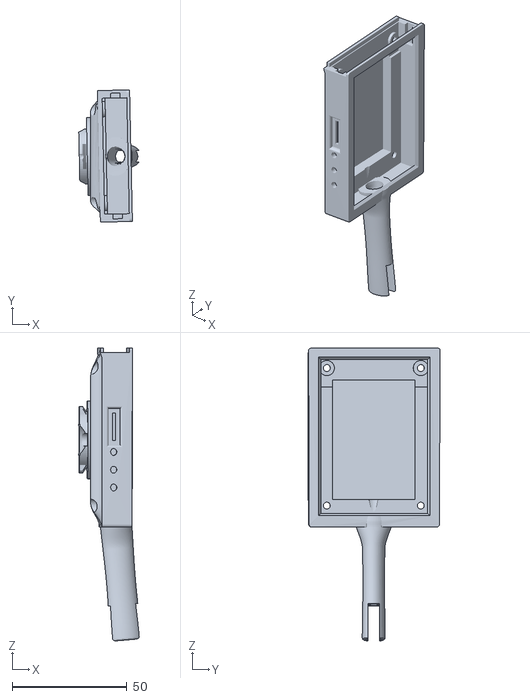
[picture p11: CAD file, 2026-10-15]
cad/aerodynamic_cycling_computer_print_reinforced.stl
26.4 x 57.7 x 127.8
