vitrum/esp32-fs3000-project/cad/aerodynamic_cycling_computer.stl

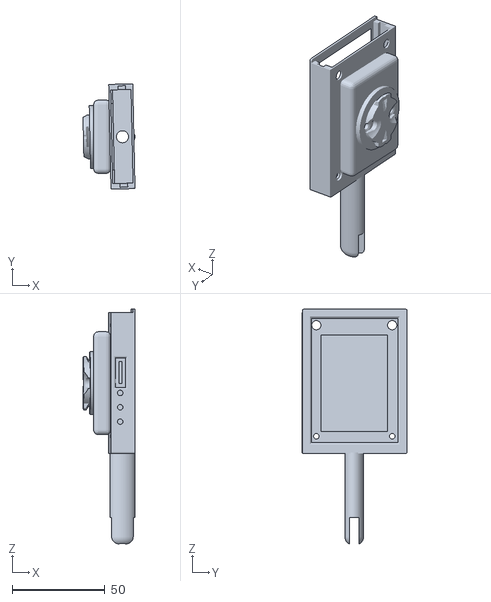
[picture p12: CAD file, 2026-10-13]
cad/aerodynamic_cycling_computer.stl
28.1 x 56.9 x 126.9
