vitrum/esp32-fs3000-project/cad/Reverse+Garmin+Custom+v2.3mf

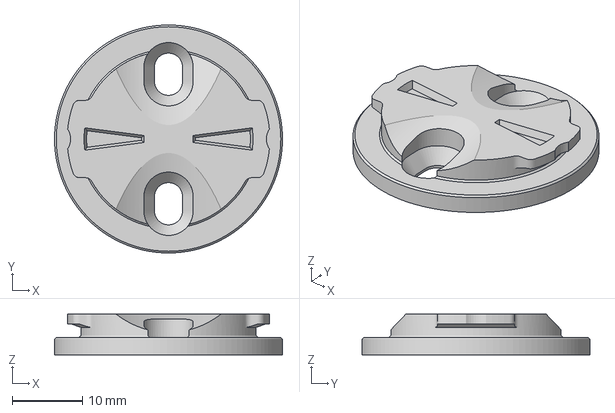
[picture p13: CAD file, 2026-10-12]
cad/Reverse+Garmin+Custom+v2.3mf
32.4 x 32.4 x 5.80 mm
