vitrum/esp32-fs3000-project/(list of files, cad)

Other CAD files:
cad/esp32-s3-touch-lcd-2_8_revised_stls/obj_4_esp32-s3-touch-lcd-2_8_2.stl
cad/esp32-s3-touch-lcd-2_8_revised_stls/obj_3_esp32-s3-touch-lcd-2_8.stl
cad/aerodynamic_cycling_computer.scad
cad/aerodynamic_cycling_computer_V3.scad
