vitrum/esp32-fs3000-project/code/src/display_lcd.h

#pragma once

#include <Arduino.h>
#include <Arduino_GFX_Library.h>
#include <Preferences.h>

#include "lv_conf.h"
#include <lvgl.h>
#include "jetbrains_mono_latin.h"

#include "battery_gauge.h"
#include "ble_power.h"
#include "saved_connections.h"
#include "wind_probe.h"
#include "csv_logger.h"   // SdFileEntry
#include "ui_navigation_guard.h"
#include "ui_touch_buffer.h"
#include "dashboard_view.h"
#include "sensor_views.h"
#include "recent_sensor_reading.h"

// ST7789 240x320 display for wind, CdA, live power, cadence, and status.
class DisplayLcd {
public:
  void begin();
  void tick();
  bool saveDashboardSettings(bool force = true);
  void update(const WindVector &w, bool windValid, float powerW, float cadRpm,
              float vgMps, float postureDeg, float rho, int pmSrc, bool logOk);
  bool takePowerSourceRequest(int &mode);
  float virtualPowerW() const { return virtualPowerW_; }
  float virtualCadenceRpm() const { return virtualCadenceRpm_; }
  bool takeBleScanRequest(SavedConnections::Role *role = nullptr);
  // 取出用户确认连接的地址，并带回该设备在扫描时记录的真实地址类型
  // （addressType 可为 nullptr）。
  bool takeBleConnectRequest(char *address, size_t capacity,
                             uint8_t *addressType = nullptr, bool *postureDevice = nullptr, bool *heartDevice = nullptr);
  bool takeBleCancelRequest();
  // 主循环处理完一次 BLE 操作后调用，允许 UI 再次接受 BLE 请求。
  void clearBleRequestInFlight() { bleRequestInFlight_ = false; }
  void showBleLoading(const char *status);
  void finishBleCancelled();
  void showBleConnectFailure(const char *error);
  // Takes ownership of devices, allocated with malloc/calloc.
  void setBleDevices(BlePowerDevice *devices, size_t count, const char *status);
  void closePowerMeterPanels();
  void updateOnlineDevices(bool powerConnected, bool powerResponding,
                           bool heartConnected, bool heartResponding,
                           bool postureConnected, bool postureResponding,
                           bool networkConnected, bool timeSynced,
                           bool windPresent, bool windResponding);
  void updateHeartDeviceStatus(bool connected, bool responding, uint16_t bpm);
  void updatePostureDeviceStatus(bool connected, bool responding,
                                 float roll, float pitch, float yaw);
  void updateRecentSensor(unsigned index, const char *text, uint32_t receivedMs);
  void refreshRecentSensors(uint32_t now, bool boardPresent, bool boardResponding);
  RiderPosture::Placement posturePlacement() const { return posturePlacement_; }
  bool takePostureCalibrationRequest(bool &leaning);
  void updatePostureEstimate(const RiderPosture::Estimate &estimate) { postureSetup_.update(estimate); }
  void showPostureCalibrationResult(bool success);
  void showUsbStorage(bool ready, bool ejected, bool hostConnected, bool active = true);
  void showUsbStorageError(const char *message) {
    usbStorageError_ = true;
    if (usbStorageStatus_) lv_label_set_text(usbStorageStatus_, message);
  }
  bool takeUsbStorageRequest(bool &enabled) {
    if (!usbStorageRequestPending_) return false;
    enabled = usbStorageRequested_;
    usbStorageRequestPending_ = false;
    return true;
  }
  void setConnectedBle(const char *address, uint8_t type, bool connected,
                       SavedConnections::Role role = SavedConnections::Role::Power);
  void updateBleFavoriteAvailability(bool connected,
                                     SavedConnections::Role role = SavedConnections::Role::Power);
  bool takeWifiEnableRequest(bool &enabled);
  bool takeWifiSetupRequest() { const bool requested = wifiSetupRequested_; wifiSetupRequested_ = false; return requested; }
  void updateWifiStatus(bool enabled, bool connected, bool provisioning,
                        const char *ssid, const char *ip);

  // ---- SD 卡文件浏览 ----
  // 用户点击设置里的 "SD CARD" 时置位，主循环据此触发文件列表加载。
  bool takeSdListRequest(char *directory, size_t capacity);
  // 主循环加载完文件后回填目录列表。
  void setSdFiles(const SdFileEntry *files, size_t count, const char *status);
  // ---- 声音设置 ----
  // 用户在声音页选择了新音量（0~100）：主循环据此设置音量并试听。
  bool takeVolumeRequest(uint8_t &vol);
  // 主循环回填当前音量，用于高亮所选档位。
  void setVolume(uint8_t vol);
  bool takeFitSaveRequest();
  // 用户在日志页点击"开始/停止记录"：主循环据此调用 logger.start()/stop()。
  // start=true 表示请求开始记录，false 表示请求停止。
  bool takeRecordingRequest(bool &start);
  // 主循环回填当前记录状态，用于切换按钮文字（RECORD / STOP）与颜色。
  void setRecording(bool recording, bool armed = false);
  void updateRideLog(const char *path, bool recording, uint32_t samples,
                     uint32_t dropped, float power, float cadence, float speed,
                     uint32_t durationMs = 0, uint32_t skipped = 0);
  void setFitSaving(bool saving);
  void showFitResult(const char *message);

  void updateNetworkTime(bool networkConnected, uint32_t utc);
  void updateTimeIndicator(bool synced);
  // 直接打开设置页面（供 BOOT 键使用）。
  void showSettings();
  void updateClock(uint32_t utc);
  void updateHeartRate(uint16_t bpm, bool valid) { dashboard_.heart(bpm, valid); }
  float estimatedCda() const { return estimatedCda_; }
private:
  Arduino_DataBus *_bus = nullptr;
  Arduino_GFX     *_gfx = nullptr;

  lv_obj_t *screen_ = nullptr;
  lv_obj_t *usbStoragePanel_ = nullptr;
  lv_obj_t *usbStorageStatus_ = nullptr;
  lv_obj_t *usbStorageButtons_[2] = {};
  lv_obj_t *usbStorageButtonLabels_[2] = {};
  bool usbStorageRequestPending_ = false;
  bool usbStorageRequested_ = false;
  bool usbStorageActive_ = false;
  bool usbStorageError_ = false;
  TouchBuffer usbStorageTouch_{BLE_UI_TOUCH_GUARD_MS};
  static void onUsbStorageButton(lv_event_t *event);
  static void onUsbStorageBack(lv_event_t *event);
  static void onUsbStorageMode(lv_event_t *event);
  float estimatedCda_ = -1;
  DashboardView dashboard_;
  bool dashboardSaveFailed_ = false;
  bool dashboardSaveNoticeShown_ = false;
  uint32_t dashboardSaveFailedAt_ = 0;
  lv_obj_t *windLabel_ = nullptr;
  lv_obj_t *powerLabel_ = nullptr;
  lv_obj_t *avg3Label_ = nullptr;
  lv_obj_t *cadenceLabel_ = nullptr;
  lv_obj_t *cadenceValueLabel_ = nullptr;
  lv_obj_t *timeLabel_ = nullptr;
  lv_obj_t *statusLabel_ = nullptr;
  lv_obj_t *networkIndicatorLabel_ = nullptr;
  lv_obj_t *statusBarTimeLabel_ = nullptr;
  lv_obj_t *powerSourceButton_ = nullptr;
  lv_obj_t *powerSourceLabel_ = nullptr;
  lv_obj_t *powerSourcePanel_ = nullptr;
  lv_obj_t *deviceHubPanel_ = nullptr;
  lv_obj_t *heartDevicePanel_ = nullptr;
  lv_obj_t *postureDevicePanel_ = nullptr;
  lv_obj_t *onlineDevicesPanel_ = nullptr;
  OnlineDevicesView onlineView_;
  PostureSetupView postureSetup_;
  RecentSensorReading onlineReadings_[OnlineDevicesView::kCount];
  RiderPosture::Placement posturePlacement_ = RiderPosture::Placement::Forearm;
  int postureCalibrationRequest_ = -1;
  bool onlineBoardPresent_ = false, onlineBoardResponding_ = false;
  static void onPosturePlacement(lv_event_t *event);
  static void onPostureCalibration(lv_event_t *event);
  lv_obj_t *deviceHubLabels_[3] = {};
  lv_obj_t *bleRoleStatusLabels_[3] = {};
  lv_obj_t *powerSourceTitle_ = nullptr;
  lv_obj_t *powerSourceHint_ = nullptr;
  lv_obj_t *powerSourceOptions_[3] = {};
  lv_obj_t *settingsPanel_ = nullptr;
  lv_obj_t *settingsTitle_ = nullptr;
  lv_obj_t *rideLogPanel_ = nullptr;
  lv_obj_t *rideLogText_ = nullptr;
  lv_obj_t *rideLogTitle_ = nullptr;
  lv_obj_t *rideLogEntryLabel_ = nullptr;
  lv_obj_t *fitSaveButton_ = nullptr;
  lv_obj_t *fitSaveLabel_ = nullptr;
  bool fitSaveRequested_ = false;
  lv_obj_t *recordButton_ = nullptr;
  lv_obj_t *recordLabel_ = nullptr;
  lv_obj_t *stopRecordButton_ = nullptr;
  lv_obj_t *stopRecordLabel_ = nullptr;
  lv_obj_t *rideDurationLabel_ = nullptr;
  bool recordingArmed_ = false;
  bool fitSaving_ = false;
  bool recordingRequested_ = false;
  bool recordingRequestStart_ = false;
  bool recording_ = false;
  uint8_t batteryCells_ = 0;      // 0..4，由 battery_gauge.h 的电压映射得出
  bool rideLogFromDashboard_ = false;
  char rideHistory_[360] = {};
  uint32_t rideLastSample_ = 0;
  uint32_t rideDurationMs_ = 0, rideSamples_ = 0, rideDropped_ = 0, rideSkipped_ = 0;
  float ridePower_ = 0, rideCadence_ = 0, rideSpeed_ = 0;
  char ridePath_[80] = {};
  lv_obj_t *settingsLanguageLabel_ = nullptr;
  lv_obj_t *settingsPowerLabel_ = nullptr;
  lv_obj_t *settingsPowerButton_ = nullptr;
  lv_obj_t *settingsPowerButtonLabel_ = nullptr;
  // 设置主页 3×2 入口按钮
  lv_obj_t *settingsLanguageEntryButton_ = nullptr;
  lv_obj_t *settingsLanguageEntryLabel_ = nullptr;
  lv_obj_t *settingsWifiEntryButton_ = nullptr;
  lv_obj_t *settingsWifiEntryLabel_ = nullptr;
  // 独立「语言」页面
  lv_obj_t *languagePanel_ = nullptr;
  lv_obj_t *languageTitle_ = nullptr;
  lv_obj_t *languageHint_ = nullptr;
  lv_obj_t *settingsLanguageButtons_[2] = {};
  lv_obj_t *settingsLanguageButtonLabels_[2] = {};
  // 独立「Wi-Fi」页面
  lv_obj_t *wifiPanel_ = nullptr;
  lv_obj_t *wifiTitle_ = nullptr;
  lv_obj_t *wifiSetupLabel_ = nullptr;
  lv_obj_t *settingsWifiLabel_ = nullptr;
  lv_obj_t *settingsWifiButtons_[2] = {};
  lv_obj_t *settingsWifiButtonLabels_[2] = {};
  lv_obj_t *settingsWifiStatus_ = nullptr;
  lv_obj_t *settingsSdButton_ = nullptr;
  lv_obj_t *settingsSdButtonLabel_ = nullptr;
  lv_obj_t *settingsSoundButton_ = nullptr;
  lv_obj_t *settingsSoundButtonLabel_ = nullptr;
  lv_obj_t *settingsTimeButton_ = nullptr;
  lv_obj_t *settingsTimeButtonLabel_ = nullptr;
  lv_obj_t *timePanel_ = nullptr;
  lv_obj_t *timeTitle_ = nullptr;
  lv_obj_t *timeStatusLabel_ = nullptr;
  lv_obj_t *timeUtcLabel_ = nullptr;
  lv_obj_t *timeInfoLabel_ = nullptr;
  lv_obj_t *soundPanel_ = nullptr;
  lv_obj_t *soundTitle_ = nullptr;
  lv_obj_t *soundVolumeLabel_ = nullptr;
  lv_obj_t *soundHint_ = nullptr;
  lv_obj_t *soundVolumeSlider_ = nullptr;
  uint8_t   currentVolume_ = 70;
  int       requestedVolume_ = -1;
  lv_obj_t *sdPanel_ = nullptr;
  lv_obj_t *sdTitle_ = nullptr;
  lv_obj_t *sdStatusLabel_ = nullptr;
  lv_obj_t *sdCurrentPathLabel_ = nullptr;
  lv_obj_t *sdList_ = nullptr;              // 可滚动列表容器
  lv_obj_t *sdRowButtons_[12] = {};         // 文件行按钮
  lv_obj_t *sdRowLabels_[12] = {};          // 行文字
  lv_obj_t *sdUpButton_ = nullptr;
  lv_obj_t *sdUpLabel_ = nullptr;
  lv_obj_t *virtualPowerPanel_ = nullptr;
  lv_obj_t *virtualPowerValueLabel_ = nullptr;
  lv_obj_t *virtualCadenceValueLabel_ = nullptr;
  lv_obj_t *virtualTitle_ = nullptr;
  lv_obj_t *virtualPowerTitle_ = nullptr;
  lv_obj_t *virtualCadenceTitle_ = nullptr;
  lv_obj_t *virtualHint_ = nullptr;
  lv_obj_t *bleDevicePanel_ = nullptr;
  lv_obj_t *bleConfirmPanel_ = nullptr;
  lv_obj_t *bleLoadingPanel_ = nullptr;
  lv_obj_t *bleLoadingTitle_ = nullptr;
  lv_obj_t *bleLoadingLabel_ = nullptr;
  lv_obj_t *bleLoadingSpinner_ = nullptr;
  lv_obj_t *bleLoadingBackButton_ = nullptr;
  lv_obj_t *bleStatusLabel_ = nullptr;
  lv_obj_t *bleDeviceTitle_ = nullptr;
  lv_obj_t *bleDeviceHint_ = nullptr;
  lv_obj_t *bleScanLabel_ = nullptr;
  lv_obj_t *bleConfirmTitle_ = nullptr;
  lv_obj_t *bleConfirmButtonLabel_ = nullptr;
  lv_obj_t *bleLoadingBackLabel_ = nullptr;
  lv_obj_t *bleConfirmNameLabel_ = nullptr;
  lv_obj_t *bleConfirmAddressLabel_ = nullptr;
  lv_obj_t *bleDeviceButtons_[kBleDevicePageSize] = {};
  lv_obj_t *bleDeviceList_ = nullptr;
  lv_obj_t *bleFavoriteButtons_[3] = {};
  lv_obj_t *bleFavoriteLabels_[3] = {};
  lv_obj_t *bleFavoriteStars_[3] = {};
  char connectedBleAddresses_[3][18] = {};
  char connectedBleNames_[3][32] = {};
  uint8_t connectedBleTypes_[3] = {};
  bool connectedBleActive_[3] = {};
  SavedConnections::Role activeBleRole_ = SavedConnections::Role::Power;
  TouchBuffer bleFavoriteTouch_{BLE_UI_TOUCH_GUARD_MS};
  static void onBleFavorite(lv_event_t *event);
  void buildBleFavoriteButton(lv_obj_t *panel, SavedConnections::Role role);
  void showBleRolePanel(SavedConnections::Role role);
  void hideDevicePanels();
  lv_obj_t *bleRolePanel(SavedConnections::Role role) const;
  void refreshBleFavoriteButton(SavedConnections::Role role);
  lv_obj_t *windLabelTitle_ = nullptr;

  int powerHistorySize_ = 3;
  float powerHistory_[3] = {0};
  int powerHistoryIndex_ = 0;

  float power3sAvg_ = 0.0f;
  float virtualPowerW_ = 0.0f;
  float virtualCadenceRpm_ = 0.0f;
  bool chinese_ = false;
  bool wifiEnabled_ = false;
  bool wifiConnected_ = false;
  bool wifiProvisioning_ = false;
  bool requestedWifiEnable_ = false;
  bool wifiEnableRequestPending_ = false;
  char wifiSsid_[33] = {};
  char wifiIp_[16] = {};
  bool bleScanCompleted_ = false;
  bool onlineBleConnected_[3] = {};
  bool onlineBleResponding_[3] = {};
  bool onlineNetworkConnected_ = false;
  bool onlineTimeSynced_ = false;
  bool onlineWindPresent_ = false;
  bool onlineWindResponding_ = false;
  uint32_t currentZone_ = 0;
  int requestedPowerMode_ = -1;
  int selectedPowerMode_ = 0;
  bool requestedBleScan_ = false;
  bool requestedBleConnect_ = false;
  // 扫描阶段记录的被选设备真实地址类型，随连接请求一起回传给主循环。
  uint8_t requestedBleAddressType_ = 0xFF;
  bool requestedBleCancel_ = false;
  bool requestedBlePosture_ = false;
    bool requestedBleHeart_ = false;
  bool wifiSetupRequested_ = false;
  bool bleOperationActive_ = false;
  char requestedBleAddress_[18] = {};
  BlePowerDevice *bleDevices_ = nullptr;
  size_t bleDeviceCount_ = 0;
  BleDevicePages bleDevicePages_;
  size_t selectedBleDevice_ = 0;
  bool touchReady_ = false;
  UiNavigationGuard navigationGuard_;

  // BLE 相关按钮的触控缓冲：吃掉重复点击与界面切换后的穿透点击。
  TouchBuffer bleScanTouch_{BLE_UI_TOUCH_GUARD_MS};
  TouchBuffer bleDeviceTouch_{BLE_UI_TOUCH_GUARD_MS};
  TouchBuffer bleConfirmTouch_{BLE_UI_TOUCH_GUARD_MS};
  TouchBuffer bleCancelTouch_{BLE_UI_TOUCH_GUARD_MS};
  // 当前是否有 UI 侧提交的 BLE 请求尚未被主循环消费。
  // 期间拒绝新的同类点击，防止同一个请求被重复投递。
  bool bleRequestInFlight_ = false;

  // ---- SD 浏览状态 ----
  bool sdListRequested_ = false;
  lv_obj_t *noticePanel_ = nullptr;
  lv_obj_t *noticeLabel_ = nullptr;
  lv_obj_t *noticeBackLabel_ = nullptr;
  char sdCurrentDirectory_[128] = "/";
  SdFileEntry sdFiles_[12] = {};
  size_t sdFileCount_ = 0;
  char sdListStatus_[64] = {};
  static void lvglFlushCb(lv_disp_drv_t *drv, const lv_area_t *area, lv_color_t *color_p);
  static void lvglTouchReadCb(lv_indev_drv_t *drv, lv_indev_data_t *data);
  static void onBackNavigation(lv_event_t *event);
  static void onPowerSourceButton(lv_event_t *event);
  static void onDeviceHubPower(lv_event_t *event);
  static void onDeviceHubHeart(lv_event_t *event);
  static void onDeviceHubPosture(lv_event_t *event);
  static void onDeviceRoleBack(lv_event_t *event);
  static void onOnlineDevicesButton(lv_event_t *event);
  static void onOnlineDevicesBack(lv_event_t *event);
  static void onBleRoleScan(lv_event_t *event);
  static void onSettingsButton(lv_event_t *event);
  static void onResetDashboard(lv_event_t *event);
  static void onSettingsBack(lv_event_t *event);
  static void onRideLogButton(lv_event_t *event);
  static void onRideLogBack(lv_event_t *event);
  static void onFitSave(lv_event_t *event);
  static void onRecordToggle(lv_event_t *event);
  static void onLanguageSelected(lv_event_t *event);
  static void onLanguageButton(lv_event_t *event);
  static void onLanguageBack(lv_event_t *event);
  static void onWifiButton(lv_event_t *event);
  static void onWifiBack(lv_event_t *event);
  static void onWifiSetup(lv_event_t *event);
  static void onWifiSelected(lv_event_t *event);
  static void onBleSelected(lv_event_t *event);
  static void onBleScanAgain(lv_event_t *event);
  static void onBlePage(lv_event_t *event);
  static void onBleDeviceSelected(lv_event_t *event);
  static void onBleConfirm(lv_event_t *event);
  static void onBleBack(lv_event_t *event);
  static void onBleConfirmBack(lv_event_t *event);
  static void onBleLoadingBack(lv_event_t *event);
  static void onAutoSelected(lv_event_t *event);
  static void onVirtualSelected(lv_event_t *event);
  static void onVirtualBack(lv_event_t *event);
  static void onVirtualSliderChanged(lv_event_t *event);
  static void onCancelSelection(lv_event_t *event);
  static void onSoundButton(lv_event_t *event);
  static void onSoundBack(lv_event_t *event);
  static void onVolumeSliderChanged(lv_event_t *event);
  static void onSdCardButton(lv_event_t *event);
  static void onSdBack(lv_event_t *event);
  static void onSdFileClicked(lv_event_t *event);
  static void onSdUpClicked(lv_event_t *event);
  static void onTimeButton(lv_event_t *event);
  static void onTimeBack(lv_event_t *event);
  static void onTimeWifiClicked(lv_event_t *event);
  static void onNoticeDismiss(lv_event_t *event);
  void showNotice(const char *message);
  static uint16_t rgb565FromLvColor(lv_color_t c);
  bool readTouch(uint16_t &x, uint16_t &y);
  bool initTouch();
  bool touchCommand(uint16_t reg);
  bool touchReadRegister(uint16_t reg, uint8_t *data, size_t len);
  bool touchWriteRegister(uint16_t reg, uint8_t value);
  void buildPowerSourcePanel();
  void buildDeviceHubPanel();
  void buildBleRolePanel(lv_obj_t *&panel, const char *title,
                         SavedConnections::Role role);
  void buildOnlineDevicesPanel();
  void buildVirtualPowerPanel();
  void buildSettingsPanel();
  void buildLanguagePanel();
  void buildWifiPanel();
  void buildSoundPanel();
  void buildSdPanel();
  void buildTimePanel();
  void buildNoticePanel();
  void refreshSoundVolume();
  void refreshSdList();
  void refreshRideLog();
  void refreshLanguage();
  void refreshBleDeviceButtons();
  void setLanguage(bool chinese);
  void refreshWifiStatus();
  const char *localized(const char *english, const char *chinese) const {
    return chinese_ ? chinese : english;
  }
  void buildPanelHeader(lv_obj_t *panel, const char *title, lv_event_cb_t backCallback);
};
