vitrum/esp32-fs3000-project/code/src/noto_sans_sc_14.c

/*******************************************************************************
 * Size: 14 px
 * Bpp: 4
 * Opts: --size 14 --bpp 4 --format lvgl --font /tmp/NotoSansCJKsc-Regular.otf --symbols 。上下不丢个中主仅件估但位低体作佩保候倾停六关内准击分判到制刷前功加动区卡原双取变可台右后听启和回固在地块基声备多失头始姿存完定实对尚层已带常度开式录待循心志态成戴所扫找把拖拟择持据接推描提搜操收放效数文断新方无日时智暂最有未本来板极架标校样次止正每气没消深源滑激点照牙率环用界留的盔目直确示禁离稍稳穿立竞等简精索级线络网置联背能臂自致英荐蓝藏虚行言计认记设试语请读败赛跳踏车轴载过运近返进连选速部配释重量钟长闭间面音预频风验骑（），： --no-kerning --no-compress --lv-include lvgl.h --lv-font-name lv_font_noto_sans_sc_14 --lv-fallback lv_font_jetbrains_mono_14 -o /Users/vitrum.zhu/Develop/ai/airpost/esp32-fs3000-project/code/src/noto_sans_sc_14.c
 ******************************************************************************/

#ifdef LV_LVGL_H_INCLUDE_SIMPLE
#include "lvgl.h"
#else
#include "lvgl.h"
#endif

#ifndef LV_FONT_NOTO_SANS_SC_14
#define LV_FONT_NOTO_SANS_SC_14 1
#endif

#if LV_FONT_NOTO_SANS_SC_14

/*-----------------
 *    BITMAPS
 *----------------*/

/*Store the image of the glyphs*/
static LV_ATTRIBUTE_LARGE_CONST const uint8_t glyph_bitmap[] = {
    /* U+3002 "。" */
    0x4, 0x95, 0x4, 0xa3, 0xa5, 0x92, 0x1, 0xa7,
    0x60, 0x58, 0xa, 0xcb, 0x0,

    /* U+4E0A "上" */
    0x0, 0x0, 0x0, 0xe2, 0x0, 0x0, 0x0, 0x0,
    0x0, 0x0, 0xe2, 0x0, 0x0, 0x0, 0x0, 0x0,
    0x0, 0xe2, 0x0, 0x0, 0x0, 0x0, 0x0, 0x0,
    0xe2, 0x0, 0x0, 0x0, 0x0, 0x0, 0x0, 0xe3,
    0x11, 0x11, 0x0, 0x0, 0x0, 0x0, 0xef, 0xff,
    0xff, 0x50, 0x0, 0x0, 0x0, 0xe2, 0x0, 0x0,
    0x0, 0x0, 0x0, 0x0, 0xe2, 0x0, 0x0, 0x0,
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
    0xe1, 0xa, 0xbf, 0xaa, 0xa6, 0x3f, 0x53, 0xf1,
    0x5, 0x7e, 0x55, 0xad, 0xcf, 0xcc, 0xf1, 0x0,
    0x2d, 0x0, 0x41, 0xe, 0x10, 0x50, 0x0, 0x2d,
    0x28, 0x0, 0xe, 0x10, 0x0, 0x0, 0x5f, 0xd6,
    0x0, 0xe, 0x10, 0x0, 0x0, 0x86, 0x0, 0x0,
    0xe, 0x10, 0x0,
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
