vitrum/esp32-fs3000-project/code/src/jetbrains_mono_16.c

/**
 * LVGL 字模：JetBrains Mono Medium 16px + FontAwesome 5 图标
 *
 * 拉丁字符 0x20-0x7E 全部等宽（同一 adv_w），实时数值刷新不抖动。
 * 图标为 FontAwesome 5 PUA 码点（LV_SYMBOL_* 使用），宽度各自独立。
 *
 * 许可证：
 *   - JetBrains Mono v2.304 —— SIL Open Font License 1.1（OFL-1.1）
 *   - FontAwesome Free 5     —— SIL OFL-1.1（字体）+ CC BY 4.0（图标）
 *   两者均免费、可商用、可嵌入固件；详见 lib/jetbrains_mono/OFL.txt
 *   与 https://fontawesome.com/license/free
 *
 * 生成：tools/build_mono_ui_font.mjs（lv_font_conv 1.5.3）
 * 源字体 SHA256: 31c92d01a8a08528b718a43addf0ad3df0af2ca4b7b3290a452f70f358e14d3d
 */
#include "lvgl.h"

#ifndef LV_FONT_JETBRAINS_MONO_16
#define LV_FONT_JETBRAINS_MONO_16 1
#endif

#if LV_FONT_JETBRAINS_MONO_16

/*-----------------
 *    BITMAPS
 *----------------*/

/*Store the image of the glyphs*/
static LV_ATTRIBUTE_LARGE_CONST const uint8_t glyph_bitmap[] = {
    /* U+0020 " " */

    /* U+0021 "!" */
    0x1f, 0xb0, 0x1f, 0xa0, 0xf, 0xa0, 0xf, 0x90,
    0xf, 0x90, 0xf, 0x90, 0xf, 0x80, 0xe, 0x80,
    0x3, 0x10, 0x0, 0x0, 0x3e, 0xc0, 0x4f, 0xc0,

    /* U+0022 "\"" */
    0xde, 0x5, 0xf6, 0xce, 0x4, 0xf6, 0xce, 0x4,
    0xf5, 0xbd, 0x3, 0xf5, 0x9a, 0x2, 0xd4,

    /* U+0023 "#" */
    0x0, 0xa, 0x80, 0xf, 0x30, 0x0, 0xc, 0x60,
    0x1f, 0x10, 0x0, 0xf, 0x30, 0x4e, 0x0, 0x0,
    0x1f, 0x10, 0x6c, 0x0, 0xd, 0xff, 0xff, 0xff,
    0xf0, 0x2, 0x8c, 0x22, 0xd8, 0x20, 0x0, 0xa9,
    0x0, 0xf4, 0x0, 0x0, 0xc6, 0x2, 0xf1, 0x0,
    0x6f, 0xff, 0xff, 0xff, 0x70, 0x14, 0xf2, 0x29,
    0xb2, 0x10, 0x6, 0xd0, 0xb, 0x70, 0x0, 0x9,
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
    0x75, 0x0, 0x0, 0xf9, 0x0, 0x0, 0x0, 0xf,
    0x90, 0x0, 0x0, 0x0, 0xf9, 0x0, 0x0, 0x0,
    0xf, 0x90, 0x0, 0x0, 0x0, 0xf9, 0x0, 0x0,
    0x0, 0xf, 0x90, 0x0, 0x0, 0x0, 0xf9, 0x0,
    0x0, 0x0, 0xf, 0x90, 0x0, 0x0, 0x0, 0xf9,
    0x0, 0x0, 0x0, 0xf, 0x90, 0x0,
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
