vitrum/esp32-fs3000-project/(commit log)

2026-10-07 添加UI
2026-10-07 提交UI修复
2026-10-07 调整功率数据
2026-10-07 努力脸上功率计
2026-10-07 成功链接骑行台模拟出功率数据
2026-10-09 Update Waveshare ESP32-S3-Touch-LCD-2.8 documentation link
2026-10-09 修复文字
2026-10-09 调整UI，修复数据刷新
2026-10-11 加点计划
2026-10-11 添加时间对其的计划和GPS计划
2026-10-11 添加wifi & web
2026-10-12 添加开关机，添加CDA文件
2026-10-12 改MIDI音乐
2026-10-13 内嵌了WAV开关机生效
2026-10-17 增加GPS
2026-10-18 增加背景故事
2026-10-19 更新，暂停使用ANT
2026-10-19 更新界面
2026-10-19 尝试修复
2026-10-19 修复蓝牙
2026-10-20 添加蓝牙手机LOG
2026-10-20 增加导出FIT
2026-10-20 关闭声音
2026-10-20 添加硬件
2026-10-22 尝试修复蓝牙问题
2026-10-22 重构测试
2026-10-22 添加测试
2026-10-24 调整UI，添加测试用例
2026-10-24 修改UI，修改存储缓存逻辑
2026-10-24 提交修复
2026-10-26 增加收藏蓝牙功率设备
2026-10-26 增加U盘模式
2026-10-27 修改U盘设置
2026-10-27 调整UI，增加心率
2026-10-27 UI调整可记录
2026-10-27 改成可写试试
2026-10-28 加点文档，AFS3000，咋办5V的电，哎
2026-10-31 调整等宽字体
2026-10-31 微调UI
2026-11-04 调整了UI
2026-11-05 更新文档
2026-11-05 微调顶部UI
2026-11-06 增加3轴感应器
2026-11-06 增加板载六轴和便携六轴对比
2026-11-08 增加讨论文档
2026-11-09 添加IMU测试文件
2026-11-09 调整模拟数据UI展示
2026-11-10 添加IMU动作捕捉和BVH回放脚本
2026-11-11 feat: Add POWER_KEY_ENABLED config switch to disable PWR button
    - Add POWER_KEY_ENABLED configuration in config.h (default: 1, enabled)
    - Set to 0 to disable GPIO6 (PWR_KEY) completely for hardware fault recovery
    - Modify PowerKey::begin() to skip GPIO initialization when disabled
    - Modify PowerKey::tick() to return early when disabled
    - Add POWER_KEY_DISABLE.md documentation with usage instructions
    This fixes the issue where the reset button (PWR_KEY) is stuck and causes
    unexpected system shutdown due to hardware malfunction. Setting
    POWER_KEY_ENABLED=0 prevents GPIO6 from being monitored or responding to
    any button press while maintaining all other system functions.
    Tested: Preprocessor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
2026-11-11 📊 烧录成功报告：POWER_KEY_ENABLED 已验证部署
2026-11-11 feat: 修复 IMU 首屏显示和 Favero Assioma 功率计识别
    - 修改首屏 IMU 显示为'在线IMU'
    - 增加 Favero Assioma 品牌名称识别，避免被过滤
    - 放宽可连接性要求，允许非标准 connectable 标记的 Assioma 设备
    - 增加 BLE 扫描时间从 6 秒到 10 秒，提高设备发现概率
    - IMU 启动连接逻辑已存在，首屏显示逻辑也已完整
2026-11-11 📋 IMU 和 Favero Assioma 修复完整报告
    - 分析了 IMU 启动连接和首屏显示逻辑
    - 修复了首屏 IMU 显示名称为'在线IMU'
    - 增加了 Favero Assioma 品牌识别
    - 放宽了可连接性要求
    - 增加了 BLE 扫描时间到 10 秒
    - 烧录验证通过，digest matched
2026-11-11 📌 添加 IMU 和 Favero 修复快速参考卡
2026-11-12 feat: add IMU device position visualization scripts
    - visualize_imu_setup.py: Matplotlib-based professional 2D visualization
    * Top-down view of ESP32 board and wearable IMU device positions
    * Shows device orientation with arrows indicating heading direction
    * Generates high-quality PNG images with orientation timeline
    * Supports output to file or interactive display
    - visualize_imu_setup_ascii.py: Terminal-based ASCII visualization
    * No external dependencies beyond Python standard library
    * Creates formatted ASCII art layout with Unicode symbols
    * Shows device positions, headings, and orientation timeline
    * Includes compass directions and bearing indicators
    Both scripts:
    -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
2026-11-12 feat: integrate IMU device position visualization into web viewer
    - Add 'Device Position & Heading' section to imu_log_viewer.html
    - New canvas elements for device layout (top-down view) and heading timeline
    - Display ESP32 board and wearable IMU positions relative to cyclist
    - Show yaw angle changes over time with interactive timeline
    - Add statistics cards for device heading data
    - Integrated with existing CSV upload and playback controls
    - Responsive design for mobile viewing
    Functions added:
    - drawDeviceLayout(): Render top-down device position diagram
    - drawDeviceTimeline(): Display yaw angle changes over time
    - updateDeviceStats(): Calculate and display heading statistics
    Co-authored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
2026-11-12 docs: add comprehensive guide for IMU viewer enhancements
    - Document new device position visualization features
    - Explain device layout canvas and heading timeline
    - List data requirements and technical implementation
    - Provide troubleshooting and usage examples
    - Compare with Python visualization scripts
    - Include development guidelines for future enhancements
2026-11-12 提交一版有问题的
2026-11-12 调整蓝牙搜索
2026-11-14 添加了IMU回放模拟器网页
2026-11-14 增加整车和假人模型
